friedeas/w3FeTAp/doc/GPIO Pins Used.png

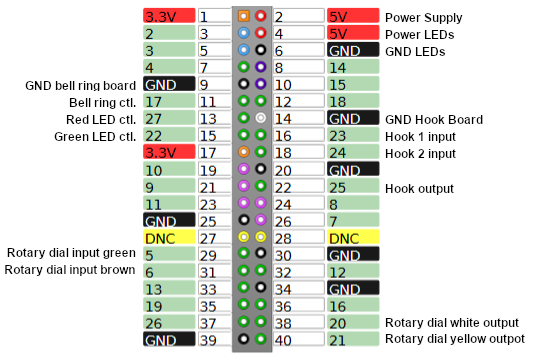
doc/GPIO Pins Used.png
