friedeas/w3FeTAp/img/Ring bell.png

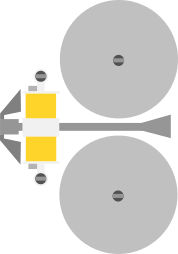
img/Ring bell.png
