friedeas/w3FeTAp/(commit log)

2024-11-15 Raspberry Pi Zero and Linphone setup documented
2024-12-07 ATTiny25 based circuit, to generate a 25 Hertz alternating voltage, added to the project
2024-12-08 reverted file type back to the original
    [telefon.c]
2024-12-08 README updated and added the bell circuit to the parts used
